cifertech/Fennec/PCB/fennec-pcb.jpg

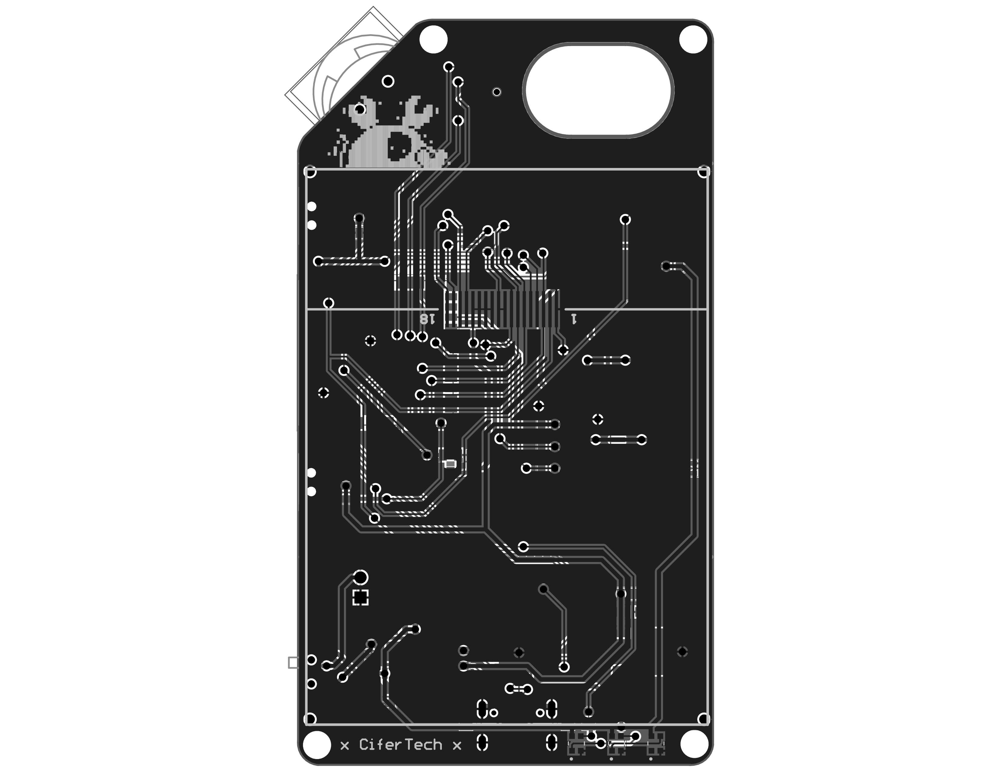
PCB/fennec-pcb.jpg
