cifertech/Fennec/Schematic/fennec-schematic.jpg

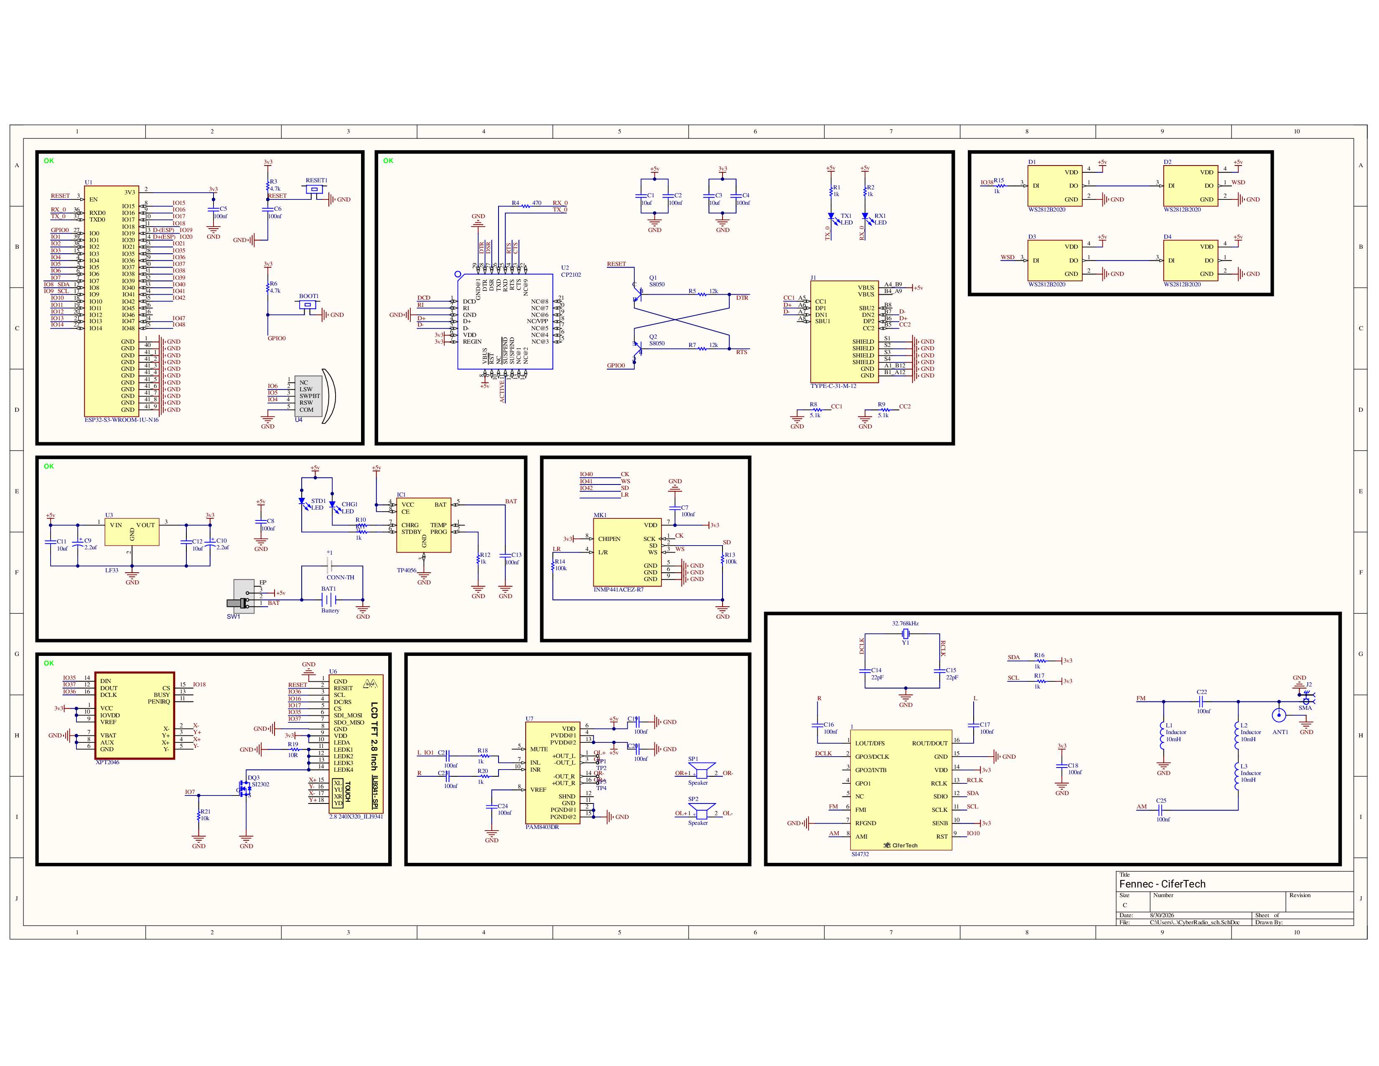
Schematic/fennec-schematic.jpg
