cifertech/Fennec/Schematic/BOM.xls

Sheet: BOM Report
Bill of Materials
Source Data From:
Project:
Variant: |  | None
Creation Date:
Print Date:
Footprint | Comment | LibRef | Designator | Description | Quantity
PCBComponent_1 | CONN-TH | CONN-TH | *1 |  | 1
PCBComponent_1 | SI4732 | SI4732 | 1 |  | 1
U.FL SMD | ANT U.FL | ANT U.FL | ANT1 | Antenna | 1
Bat | Battery | Battery | BAT1 |  | 1
PUSH BUTTON SMD | BUTTON | PUSH BUTTON RIGHT | BOOT1, RESET1 | PUSH BUTTON | 2
C 0805 | 10uf | CAP SMD | C1, C3, C11, C12 | Capacitor | 4
C 0805 | 100nf | CAP SMD | C2, C4, C5, C6, C7, C8, C13, C16, C17, C18, C19, C20, C21, C22, C23, C24, C25 | Capacitor | 17
Tan 1206 (3216X18L) Size A | Capacitor Tantalum SMD | Capacitor Tantalum SMD | C9, C10 | Capacitor Tantalum SMD | 2
C 0603 | 22pF | CAP SMD | C14, C15 | Capacitor | 2
LED_0603 | LED | LED | CHG1, RX1, STD1, TX1 | LED | 4
LED_WS2812B2020 | WS2812B2020 | WS2812B2020 | D1, D2, D3, D4 | LED; SMD; 2020; RGB; 2x2x0.84mm; 3.7Ã·5.3V; Lens: transparent; 2kHz | 4
SOP-8 | TP4056 | TP4056 | IC1 | Complete single cell Li-Ion battery with a constant current / constant voltage linear charger | 1
HRO_TYPE-C-31-M-12 | TYPE-C-31-M-12 | TYPE-C-31-M-12 | J1 | USB Connectors 24 Receptacle 1 8.94*7.3mm RoHS | 1
SAMTEC_SMA-J-P-H-ST-EM1 | SMA | SMA-J-P-H-ST-EM1 | J2 | SMA Connector Jack, Female Socket 50Ohm Board Edge, End Launch Solder | 1
INDC1608L | Inductor | Inductor | L1, L2, L3 | Inductor | 3
MIC_INMP441ACEZ-R7 | INMP441ACEZ-R7 | INMP441ACEZ-R7 | MK1 | 60 Hz ~ 15 kHz Digital, I2S Microphone MEMS (Silicon) 1.62 V ~ 3.63 V Omnidirectional (-26dB Â±3dB @ 94dB SPL) Solder Pads | 1
SOT-23 | S8050 | SMD-TRANSISTORS-NPN-25V-500MW(SOT-23) | Q1, Q2 | Bipolar (BJT) Transistor NPN 25 V 500 mA 150MHz 300 mW Surface Mount SOT-23 | 2
SOT23 | SI2302 | SI2302 | Q3 | N-Channel 20 V 2.6A (Ta) 710mW (Ta) Surface Mount SOT-23-3 (TO-236) | 1
RES 0805 (2012X06L) | 1k | RES | R1, R2, R10, R11, R12, R15, R16, R17, R18, R20 | RESISTOR | 10
RES 0805 (2012X06L) | 4.7k | RES | R3, R6 | RESISTOR | 2
RES 0805 (2012X06L) | 470 | RES | R4 | RESISTOR | 1
RES 0805 (2012X06L) | 12k | RES | R5, R7 | RESISTOR | 2
RES 0805 (2012X06L) | 5.1k | RES | R8, R9 | RESISTOR | 2
RES 0805 (2012X06L) | 100k | RES | R13, R14 | RESISTOR | 2
RES 0805 (2012X06L) | 10R | RES | R19 | RESISTOR | 1
RES 0805 (2012X06L) | 10k | RES | R21 | RESISTOR | 1
SP_AL11P | Speaker | Speaker | SP1, SP2 | Speaker | 2
SWSLIDT_SPDT_MSS3 | SlideSwitch | SWSLIDT_SPDT_MSS3 | SW1 | SWITCH, SLIDE, SPDT, SMD | 1
TP20SQ |  | Test Point | TP1, TP2, TP3, TP4 | Test Point | 4
XCVR_ESP32-S3-WROOM-1U-N16 | ESP32-S3-WROOM-1U-N16 | ESP32-S3-WROOM-1U-N16 | U1 | Bluetooth, WiFi 802.11b/g/n, Bluetooth v5.0 Transceiver Module 2.4GHz Antenna Not Included, U.FL Surface Mount | 1
QFN28G_0.5-5X5MM | CP2102 | INTERFACE-CP2102-GMR(QFN28) | U2 | USB Bridge, USB to UART USB 2.0 UART Interface 28-QFN _5x5_ | 1
D-PACK | LF33 | LF33 | U3 | 3.3V VOLTAGE REGULATOR | 1
SWCRE_SMD_13X13 | CrescentSwitch | SWCRE_SMD_13X13 | U4 | SWITCH, CRESCENT, 13X13mm, SMD | 1
TSSOP16 | XPT2046 | XPT2046 | U5 | Touch Screen Controller | 1
LCDTFT_1.8IN_ST7735_18P | 2.8 240X320_ILI9341 | LCD_TFT_Color_2.8 240X320_ILI9341 Driver_FLAT | U6 | LCD TFT FULL Color 2.8 240X320 ILI9341 Driver FLAT | 1
SOIC127P605X150-16N | PAM8403DR | PAM8403DR | U7 | Amplifier IC 2-Channel _Stereo_ Class D 16-SOP | 1
SMD_XTAL RTC - H | 32.768kHz | XTAL_Crystal | Y1 | XTAL Crystal | 1
 |  |  |  |  | 85
Approved |  | Notes

Sheet: Project Information
Project Full Path | C:\Users\Public\Documents\Altium\Projects\CyberRadio\CyberRadio.PrjPcb
Project Filename | CyberRadio.PrjPcb
Variant Name | None
Data-Source Filename | CyberRadio.PrjPcb
Data-Source Full Path | C:\Users\Public\Documents\Altium\Projects\CyberRadio\CyberRadio.PrjPcb
Title | Bill of Materials for Project [CyberRadio.PrjPcb] (No PCB Document Selected)
Total Quantity | 85
Report Time | 2:47 AM
Report Date | 8/30/2026
Report Date & Tine | 8/30/2026 2:47 AM
Output Name | Bill of Materials
Output Type | BOM_PartType
Output Generator Name | BOM
Output Generator Description | Bill of Materials
