cifertech/Fennec/Fennec/Pins.h

#pragma once


#ifndef PIN_I2C_SDA
#define PIN_I2C_SDA 8
#endif
#ifndef PIN_I2C_SCL
#define PIN_I2C_SCL 9
#endif
#ifndef PIN_RADIO_RESET
#define PIN_RADIO_RESET 10
#endif

#ifndef PIN_TFT_MISO
#define PIN_TFT_MISO 13
#endif
#ifndef PIN_TFT_MOSI
#define PIN_TFT_MOSI 11
#endif
#ifndef PIN_TFT_SCLK
#define PIN_TFT_SCLK 12
#endif
#ifndef PIN_TFT_CS
#define PIN_TFT_CS 14
#endif
#ifndef PIN_TFT_DC
#define PIN_TFT_DC 21
#endif
#ifndef PIN_TFT_RST
#define PIN_TFT_RST 47
#endif
#ifndef PIN_TFT_BL
#define PIN_TFT_BL 48
#endif

#ifndef PIN_TOUCH_DIN
#define PIN_TOUCH_DIN 35
#endif
#ifndef PIN_TOUCH_DO
#define PIN_TOUCH_DO 37
#endif
#ifndef PIN_TOUCH_CLK
#define PIN_TOUCH_CLK 36
#endif
#ifndef PIN_TOUCH_CS
#define PIN_TOUCH_CS 18
#endif

#ifndef PIN_BTN_UP
#define PIN_BTN_UP 6
#endif
#ifndef PIN_BTN_OK
#define PIN_BTN_OK 5
#endif
#ifndef PIN_BTN_DOWN
#define PIN_BTN_DOWN 4
#endif

#ifndef PIN_AMP_SD
#define PIN_AMP_SD 7
#endif
#ifndef PIN_AMP_SD_ACTIVE_HIGH
#define PIN_AMP_SD_ACTIVE_HIGH 1
#endif

#ifndef PIN_MIC_CK
#define PIN_MIC_CK 40
#endif
#ifndef PIN_MIC_WS
#define PIN_MIC_WS 41
#endif
#ifndef PIN_MIC_SD
#define PIN_MIC_SD 42
#endif

#ifndef PIN_NEOPIXEL
#define PIN_NEOPIXEL 38
#endif
#ifndef FENNEC_NEOPIXEL_COUNT
#define FENNEC_NEOPIXEL_COUNT 3
#endif

#ifndef PIN_SSTV_ADC
#define PIN_SSTV_ADC 1
#endif
